lorimer/weatherscreen/case/out/preview_tray_back.png

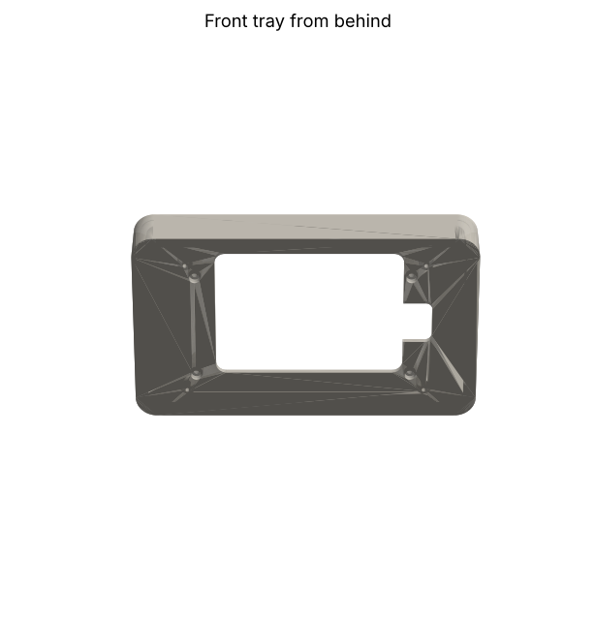
case/out/preview_tray_back.png
