lorimer/weatherscreen/docs/boot_screen_reference.png

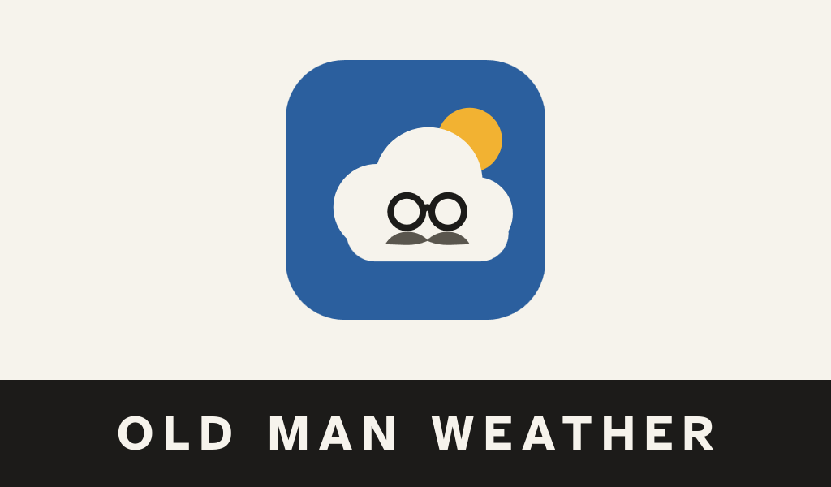
docs/boot_screen_reference.png
