lorimer/weatherscreen/docs/web_trends_week.png

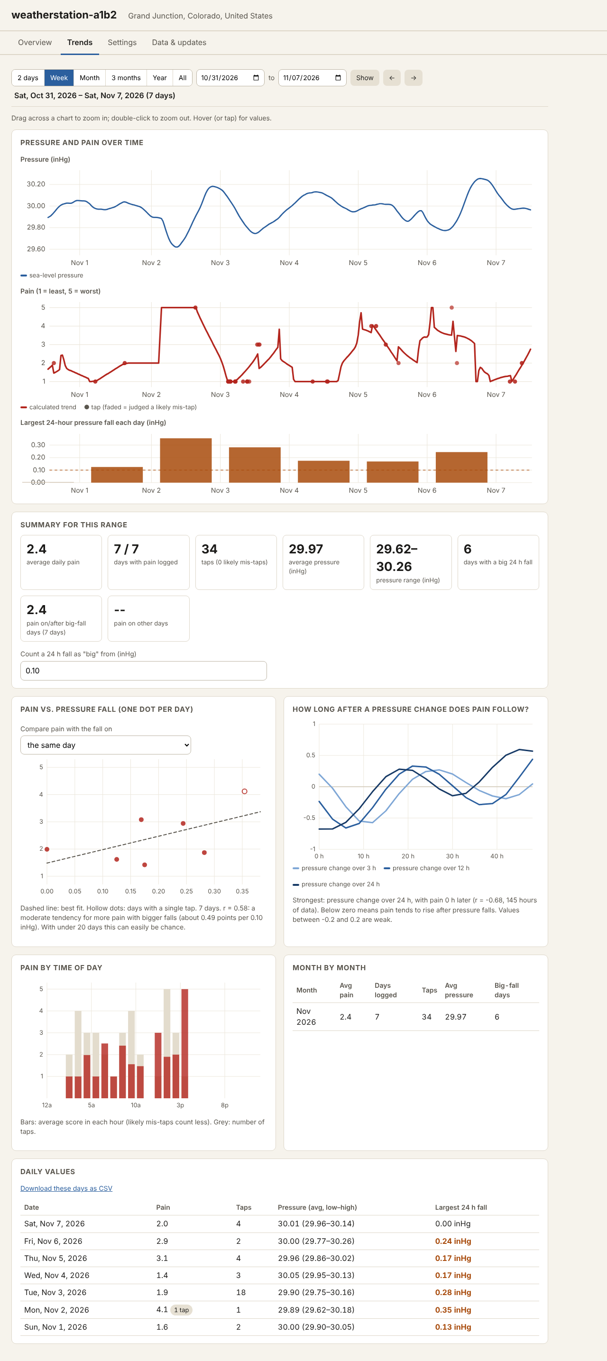
docs/web_trends_week.png
