lorimer/weatherscreen/case/out/assembly_preview.step

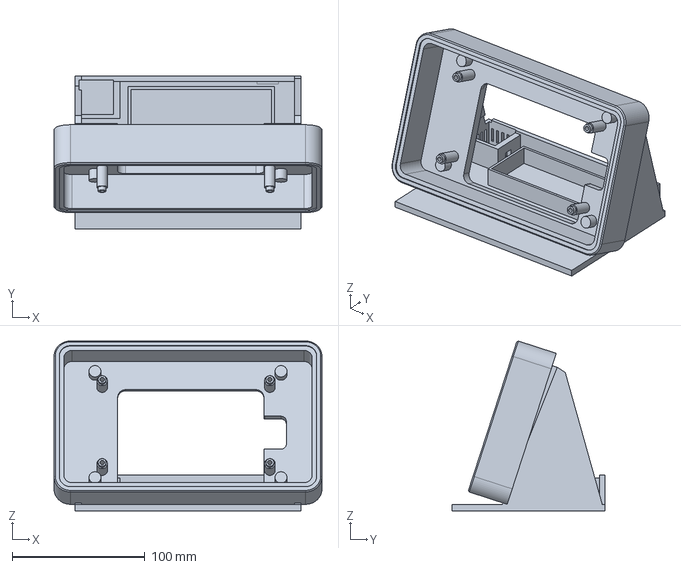
[picture p13: CAD file, 2026-11-07]
case/out/assembly_preview.step
201.7 x 115.0 x 127.9 mm
