lorimer/weatherscreen/case/out/front_tray.step

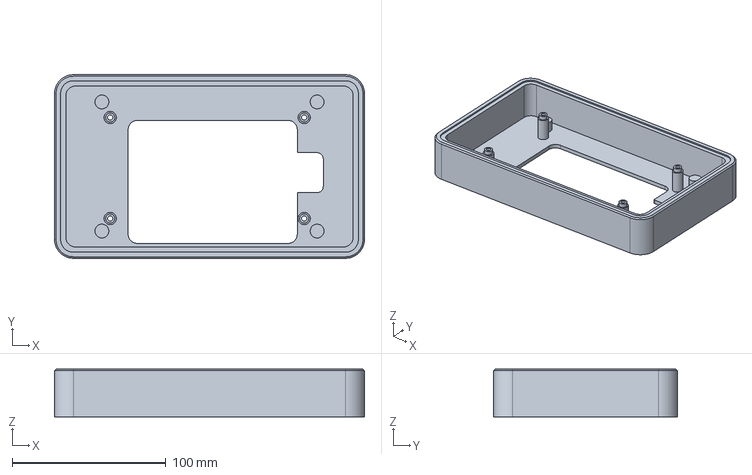
[picture p14: CAD file, 2026-11-07]
case/out/front_tray.step
201.7 x 119.5 x 31.0 mm
