lorimer/weatherscreen/case/out/stand.step

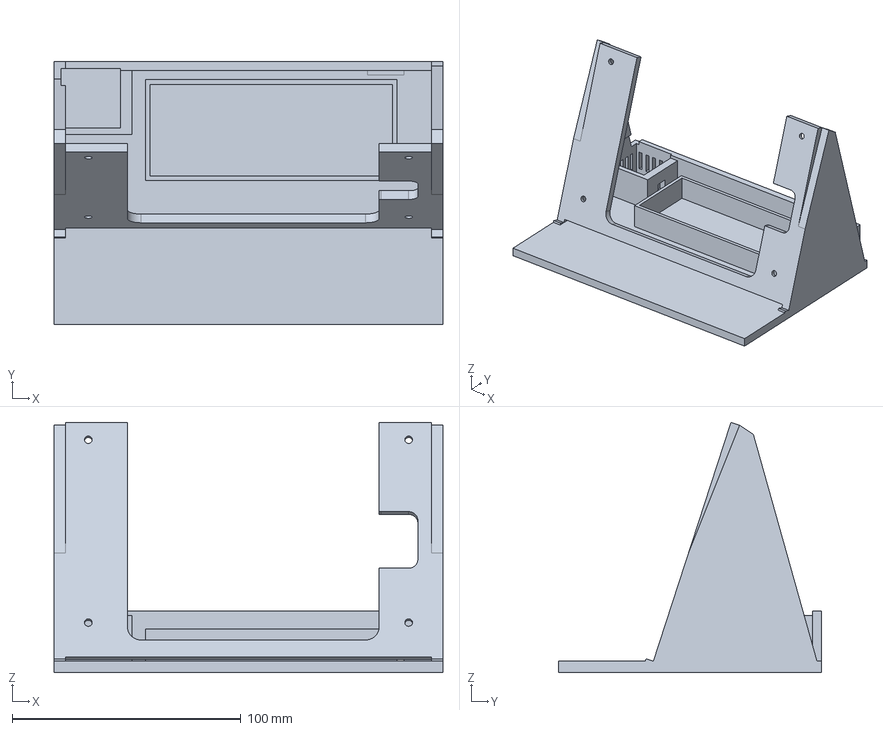
[picture p15: CAD file, 2026-11-07]
case/out/stand.step
170.0 x 115.0 x 109.4 mm
