lorimer/weatherscreen/(list of files, cad)

Other CAD files:
case/out/front_tray.stl
case/out/stand.stl
