lorimer/weatherscreen/docs/4_setup_wifi_list.png

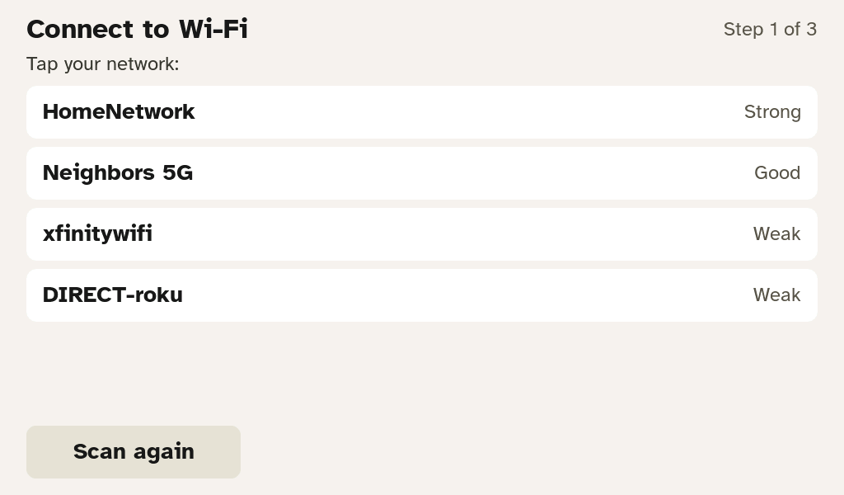
docs/4_setup_wifi_list.png
