lorimer/weatherscreen/(commit log)

2026-11-07 Weather & Pain Station: firmware, case, analysis tools
    ESP32-S3 (Waveshare ESP32-S3-Touch-LCD-7B) tabletop weather display with
    one-tap pain logging, barometric pressure tracking, robust pain-trend
    analysis, web management UI, OTA updates, and a 3D-printed case.
    Claude-Session: https://claude.ai/code/session_01JT6ReVWG3rsJEJWgqesv5f
    [assembly_preview.step, front_tray.step, front_tray.stl, partitions.csv, stand.step, stand.stl]
2026-11-07 Test rig: run the real UI on a LilyGO T-Display-S3
    The station's panel is 1024x600; this board is 320x170. Rather than redesign the UI
    for the small screen, LVGL still renders the real, unmodified 1024x600 screen into a
    PSRAM canvas and the panel shows a view of it: the whole screen scaled down, or a
    320x170 window at true pixel size with drag-to-pan. Triple tap or KEY switches views,
    BOOT steps the window across the screen.
    board_tdisplay.cpp provides the same board:: API over an i80 ST7789 and CST816 touch,
    and replaces board.cpp for env:tdisplay only. It is wrapped in #ifdef BOARD_TDISPLAY_S3
    and excluded from the default src filter, so the Waveshare build cannot pick it up.
    No SD card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
    [board_tdisplay.cpp, storage.cpp]
2026-11-07 Fix the forecast fetch: Open-Meteo sends chunked responses
    The dashboard never showed weather. The request returned HTTP 200 but the parse failed
    with "JSON: InvalidInput", because /v1/forecast answers with Transfer-Encoding: chunked
    and HTTPClient's getStream() returns the raw socket, so the chunk-size lines reached
    ArduinoJson.
    http.useHTTP10(true) drops chunked encoding while still letting us stream the body, so
    the response never has to be held in RAM whole.
    The geocoding endpoint sends a Content-Length and so always parsed, which is why the
    location search worked during setup while the main screen stayed empty.
    This was never a test-rig problem: the same code would have failed on the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
    [weather.cpp]
2026-11-07 Test rig: let press-and-hold through in the 1:1 view
    In the 1:1 view a touch was only delivered on release, and only if it lasted under half
    a second, so that a drag could pan instead of pressing whatever was under the finger.
    That made every press-and-hold gesture impossible there -- including the ten-second hold
    on the date that opens Maintenance, so the settings screen could only be reached from
    the scaled view, where it cannot be read.
    A finger that moves past the pan slop still pans. One that stays put is now passed
    through as a live press after 120 ms and held until release, so holds and drags inside a
    widget behave. A tap too quick for that is still replayed as a click on release, on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
    [board_tdisplay.cpp]
2026-11-07 Settings screen: IP address and signal strength, kept live
    The maintenance screen folded the IP into the web-page line and the signal into the
    Wi-Fi line, and built every value once when the screen opened, so anything that
    changed afterwards stayed stale -- including an address that did not exist yet when the
    screen was drawn.
    The address now has its own line in a larger face, signal strength has its own line, and
    the lines that go out of date refresh every second. Signal strength leads with a word
    (excellent/good/fair/weak/very weak) and keeps the dBm in brackets, since dBm means
    little to whoever is reading this screen.
    The "All set" screen at the end of setup shows the address the same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
2026-11-07 Pressure and pain share a 3-day axis
    Both charts were already drawn from the same series array, so they always shared a time
    scale, but the window was 48 h. It is now 72 h at the same 30-minute step, so the
    screen shows the last 3 days.
    The forecast request asks for past_days=3 to match, otherwise the oldest day of the
    pressure graph has no data on a unit with no sensor, where pressure comes from the
    API's hourly history.
    The single unlabelled midline becomes two gridlines on the day boundaries, and the axis
    reads "3 days ago" to "Now".
    Also: the maintenance screen now states the web user name (admin). The screen at the end
    of setup always did, but there was no way to look it up afterward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
2026-11-07 Test rig: a console to fill the graphs with days of data
    Waiting days to see what the history graphs look like is impractical, so the test rig
    build gets a small serial console:
    seed [days] generate random taps that fit the patterns in the spec: irregular use,
    quiet days, bursts that the analysis counts as one episode, and one
    deliberate mis-tap. Levels are shaped by the real pressure history, so
    pain follows pressure falls and the two graphs visibly relate.
    dilate <min> spread the next <min> minutes of real tapping across 3 days
    clear delete all pain taps
    status what is on, and how much data there is
    history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
2026-11-07 Smooth the pain trend: remove three steps in the estimator
    The trend line jumped. Measured over a 3-day window with realistic sparse taps, the
    largest change between two adjacent 30-minute samples was 2.25 points -- on a scale of
    1 to 5. Three discontinuities caused it:
    - the kernel width stepped from bandwidth_h to gap_h the moment the nearest tap fell
    outside the bandwidth, so it changed abruptly as the sample time slid along;
    - local_fit switched between local-linear and local-constant on an on/off test for taps
    "on both sides", so the estimator changed form as the sample time swept past a tap;
    - the slope term was applied undamped whenever that test passed, and with nearly
    coincid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
2026-11-07 Log internet pressure every 30 minutes, not hourly
    The forecast was already fetched every 15 minutes, but on a unit with no sensor the
    pressure it carries was only written to the log once an hour. Thirty minutes lines the
    log up with the 30-minute grid the history graph is drawn on, and storage is nowhere
    near the constraint: a row is about 36 bytes, so this is roughly 1.7 kB a day and under
    650 kB a year.
    Open-Meteo's own pressure resolution is hourly, so some consecutive rows will repeat a
    value. That costs nothing and means nothing is missed when the API does update sooner.
    The interval is now a slot comparison rather than an elapsed-time guard, so a late run
    cannot push the following s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
    [config.h, history.cpp]
2026-11-07 Settings: flip the display 180 degrees
    A new maintenance button turns the picture and touch upside down, saved in NVS and
    reapplied at start-up, for a unit that ends up standing the other way round.
    On the Waveshare panel the turn is done in the flush path: a 180 degree rotation of a
    rectangular block is its pixels in reverse order, since the rows are contiguous. That
    works whether or not the RGB driver supports esp_lcd_panel_mirror(), which it does not
    advertise -- worth knowing, because this is one of the things that cannot be checked
    until the 7B is in hand.
    On the test rig the presenter already rotates, so the setting composes with the
    constant describing how that panel is mounted.
    To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
    [board.cpp, board.h, board_tdisplay.cpp, settings.cpp, settings.h, ui.cpp, ui_setup.cpp]
2026-11-07 Pain buttons run blue to red, not green to red
    Red/green is the pair most often confused, and these buttons are the one control the
    user has. Blue to red avoids it.
    The ramp also falls about 2.4 L* a step as the hue turns, so the scale still reads as a
    progression if the colours do not register at all -- the old green-to-red ramp varied
    almost entirely by hue, at a near-constant lightness. White text clears 4.5:1 on all
    five, from 5.0 at the blue end to 7.2 at the red.
    It runs cool to warm through a desaturated middle rather than straight through magenta.
    The straight interpolation is the more literal reading of "blue to red" but looks like a
    rainbow rather than a severity scale.
    The ends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
    [config.h]
2026-11-07 Test rig: the panel is RGB, not BGR
    Red and blue were swapped on the test rig's panel. The colour order was read across
    from LovyanGFX's rgb_order = false for this board, which reads as BGR, but that is the
    opposite polarity to esp_lcd's rgb_ele_order, so copying it across exchanged the two
    channels.
    The symptom was subtle because green is the untouched channel, so only the ends of a
    ramp move: the old green-to-red pain buttons appeared green-to-blue, which is what gave
    it away. It also meant the pressure line was drawn red and the pain line blue, and the
    logo's blue tile came out rust.
    Rig only -- the Waveshare panel is parallel RGB with the data lines wired in a fixed
    order and has no eq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
    [board_tdisplay.cpp]
2026-11-07 Remove the T-Display-S3 bring-up rig; v1.2.0
    The LilyGO port was only ever a way to run the firmware on real silicon before the
    Waveshare 7B arrives. It has done that job, so it goes: board_tdisplay.cpp, the
    testrig console that seeded synthetic taps and dilated time, the add_tap_at and
    clear_taps hooks in history, the SD guard in storage, the tdisplay env and the src
    filters that kept it out of the shipping build. The only target is the 7B again.
    The product changes it led to all stay, and they are the point of having done it:
    - the forecast fetch, which never parsed at all (Open-Meteo sends it chunked);
    - the pain trend, which jumped over 2 points between adjacent 30-minute samples;
    - th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
2026-11-08 Old Man Weather everywhere; bring the rig back without it touching production
    The name is now the product's name in every place a person sees it: the boot screen
    already said it, and so now do the README, the web page title and header, the HTTP auth
    realm, the serial banner, the case source, the LVGL config and CLAUDE.md. The default
    device name, which becomes the mDNS hostname, goes from weatherstation-xxxx to
    oldmanweather-xxxx; existing units keep the name stored in NVS.
    The T-Display bring-up rig comes back, rebuilt so it cannot weigh the product down:
    - board_tdisplay.cpp and testrig.cpp are excluded from [env] and guarded by
    #ifdef BOARD_TDISPLAY_S3, so only env:tdisplay compiles t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
